kr-Eliza/tkey-open-hardware-reproduction/docs/images/render-3d-top.png

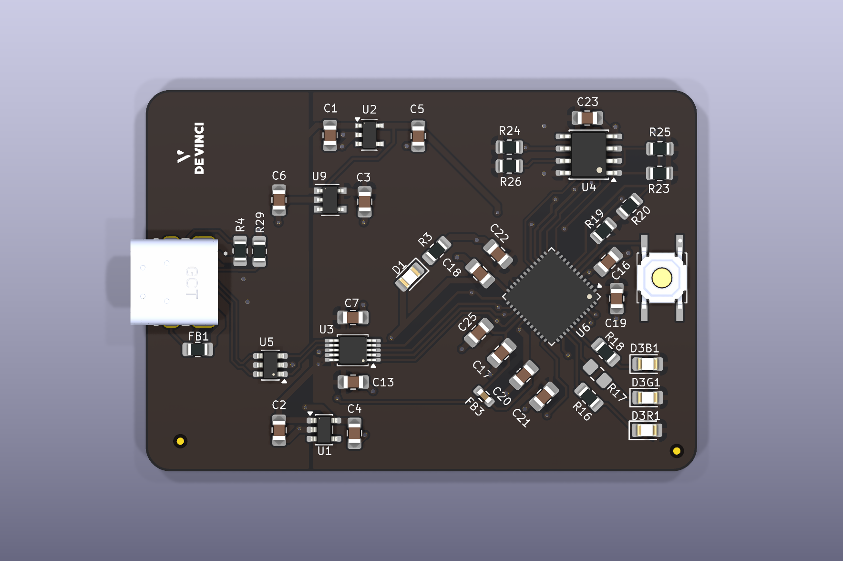
docs/images/render-3d-top.png
