kr-Eliza/tkey-open-hardware-reproduction/hardware/tk1-2layer/bom.csv

Reference | Value | Footprint | QUANTITY
C1-C6,C25 | 10uF | Capacitor_SMD:C_0805_2012Metric_Pad1.18x1.45mm_HandSolder | 7
C7,C13,C16-C23 | 0.10uF | Capacitor_SMD:C_0805_2012Metric_Pad1.18x1.45mm_HandSolder | 10
D1 | 0805 indicator LED, blue | LED_SMD:LED_0805_2012Metric_Pad1.15x1.40mm_HandSolder | 1
D3B1,D3G1,D3R1 | LED | LED_SMD:LED_0805_2012Metric_Pad1.15x1.40mm_HandSolder | 3
FB1 | FerriteBead | Resistor_SMD:R_0805_2012Metric_Pad1.20x1.40mm_HandSolder | 1
J3 | USB4085-GF-A_REVB | mta1:GCT_USB4085-GF-A_REVB | 1
R3,R16-R18 | 1k | Resistor_SMD:R_0805_2012Metric_Pad1.20x1.40mm_HandSolder | 4
R4,R29 | 5.1k | Resistor_SMD:R_0805_2012Metric_Pad1.20x1.40mm_HandSolder | 2
R19,R20,R23-R26 | 10k | Resistor_SMD:R_0805_2012Metric | 6
SW2 | PTS526_SK15_SMTR2_LFS | footprints:PTS526SK15SMTR2LFS | 1
U1 | MCP1824T-2502EOT | Package_TO_SOT_SMD:SOT-23-5 | 1
U2 | NCV8164ASN120T1G | Package_SO:TSOP-5_1.65x3.05mm_P0.95mm | 1
U3 | CH552E | Package_SO:MSOP-10_3x3mm_P0.5mm | 1
U4 | SST25VF080B-50-4x-S2Ax | Package_SO:SOIC-8_3.9x4.9mm_P1.27mm | 1
U5 | USBLC6-2SC6 | Package_TO_SOT_SMD:SOT-23-6 | 1
U6 | ICE40UP5K-SG48ITR | Package_DFN_QFN:QFN-48-1EP_7x7mm_P0.5mm_EP5.3x5.3mm | 1
U9 | NCP752BSN33T1G | mta1:NCP752BSN33T1G | 1
