kr-Eliza/tkey-open-hardware-reproduction/docs/schematic-2layer.pdf

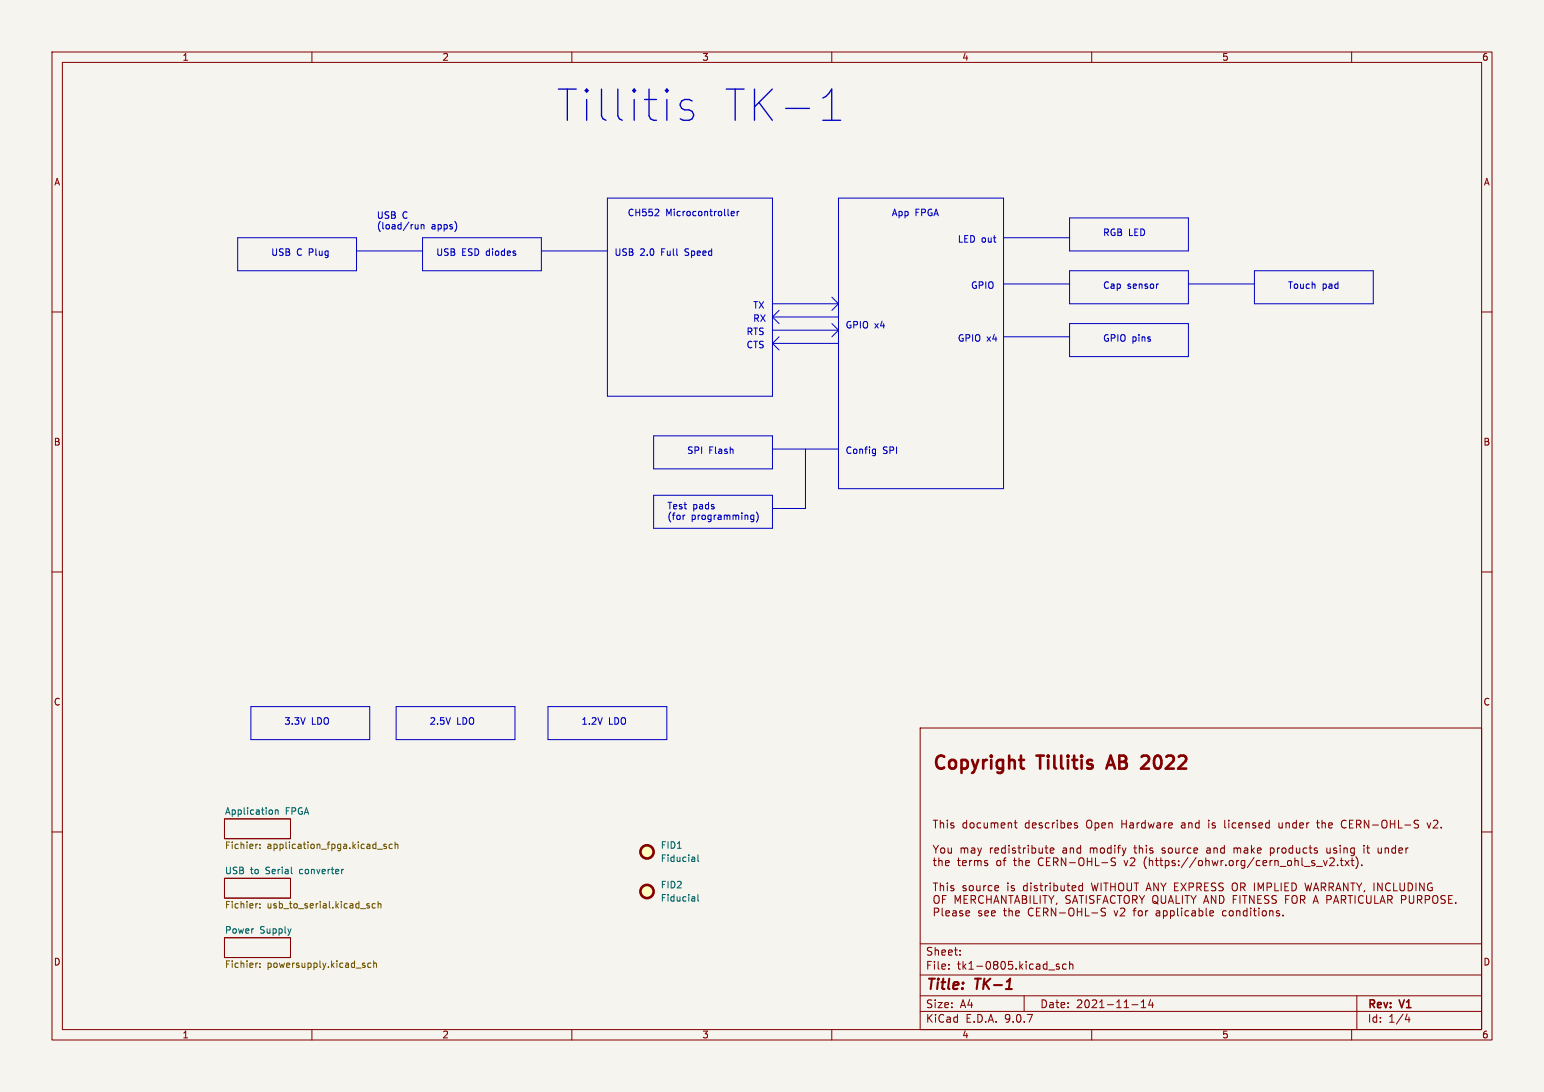
[picture p14: page 1]

(for programming) TX RTSRX CTS USB C

Touch pad Test pads

Power Supply Fichier: powersupply.kicad_sch

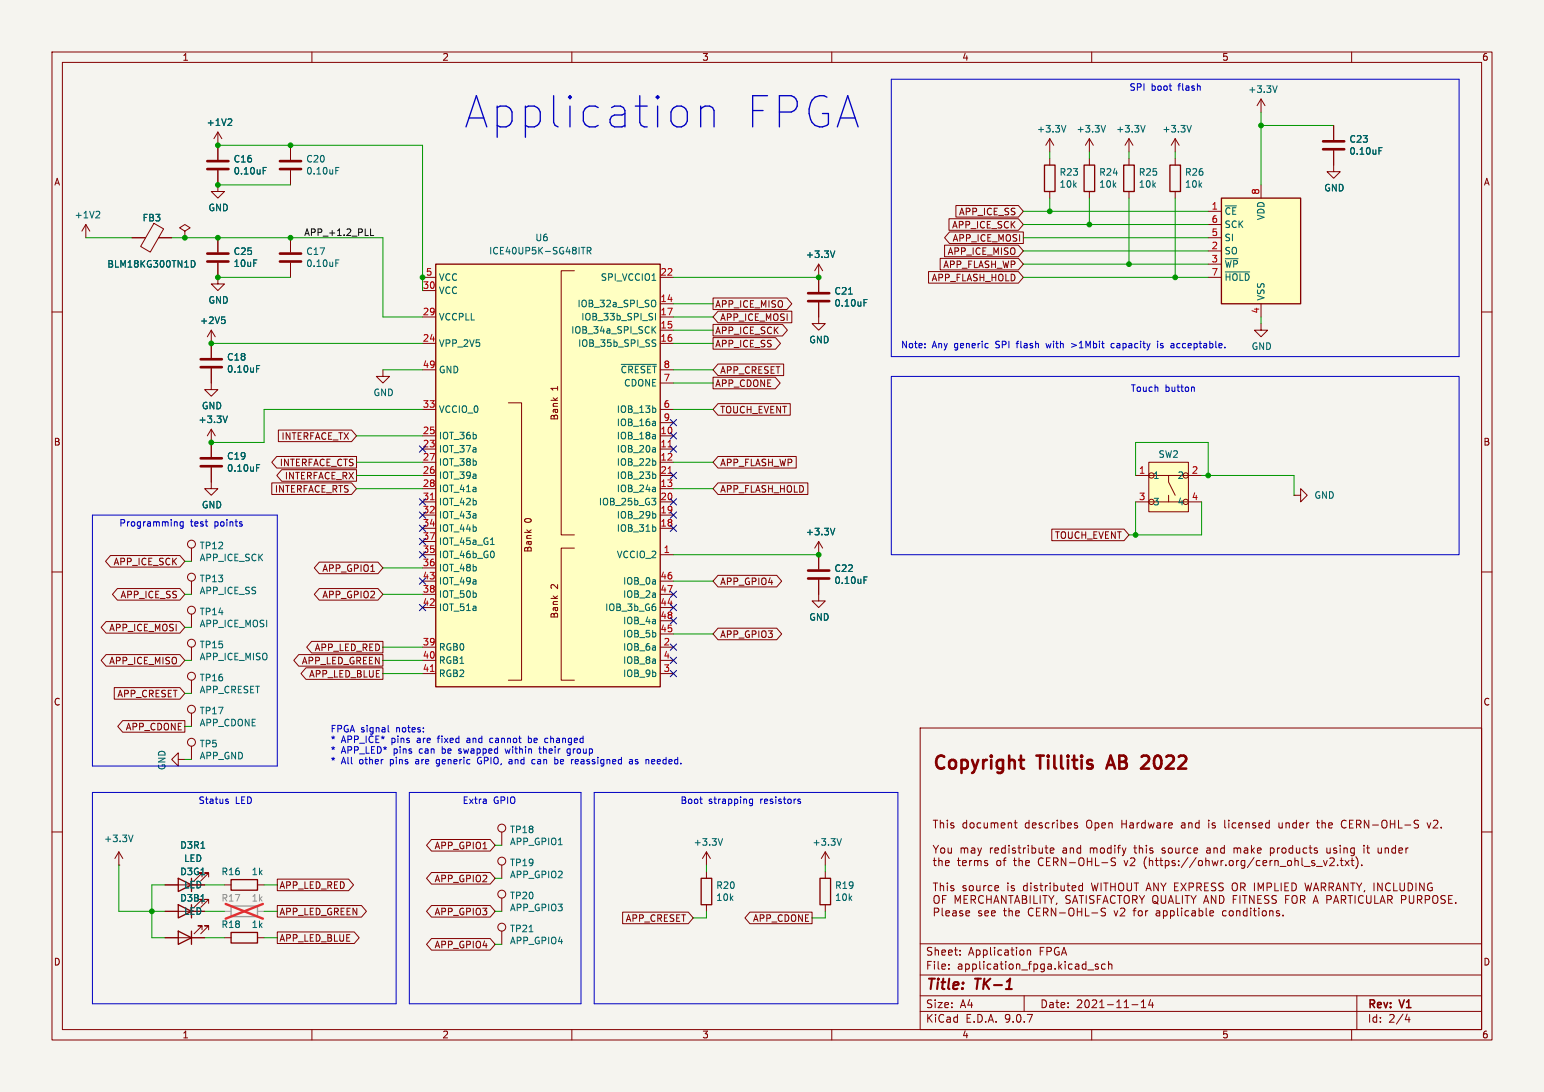
[picture p15: page 2]

FPGA signal notes: * APP_ICE* pins are fixed and cannot be changed

* APP_LED* pins can be swapped within their group

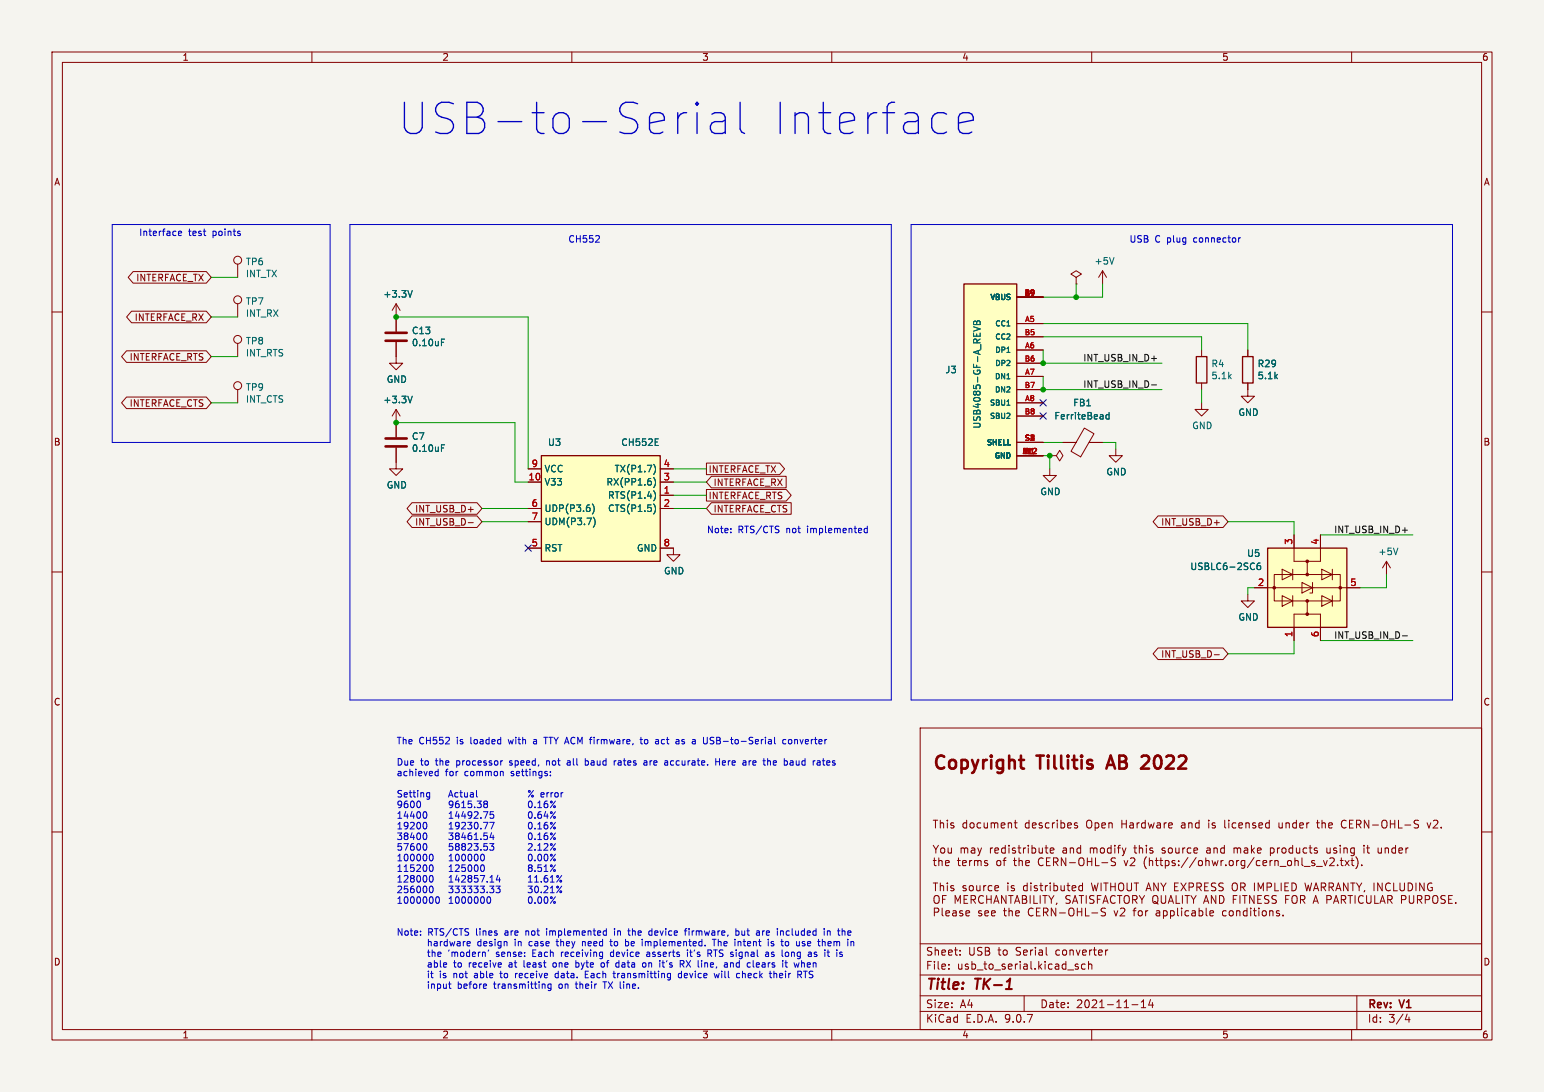
[picture p16: page 3]

4 U5 USBLC6-2SC6 GND GND GND GND

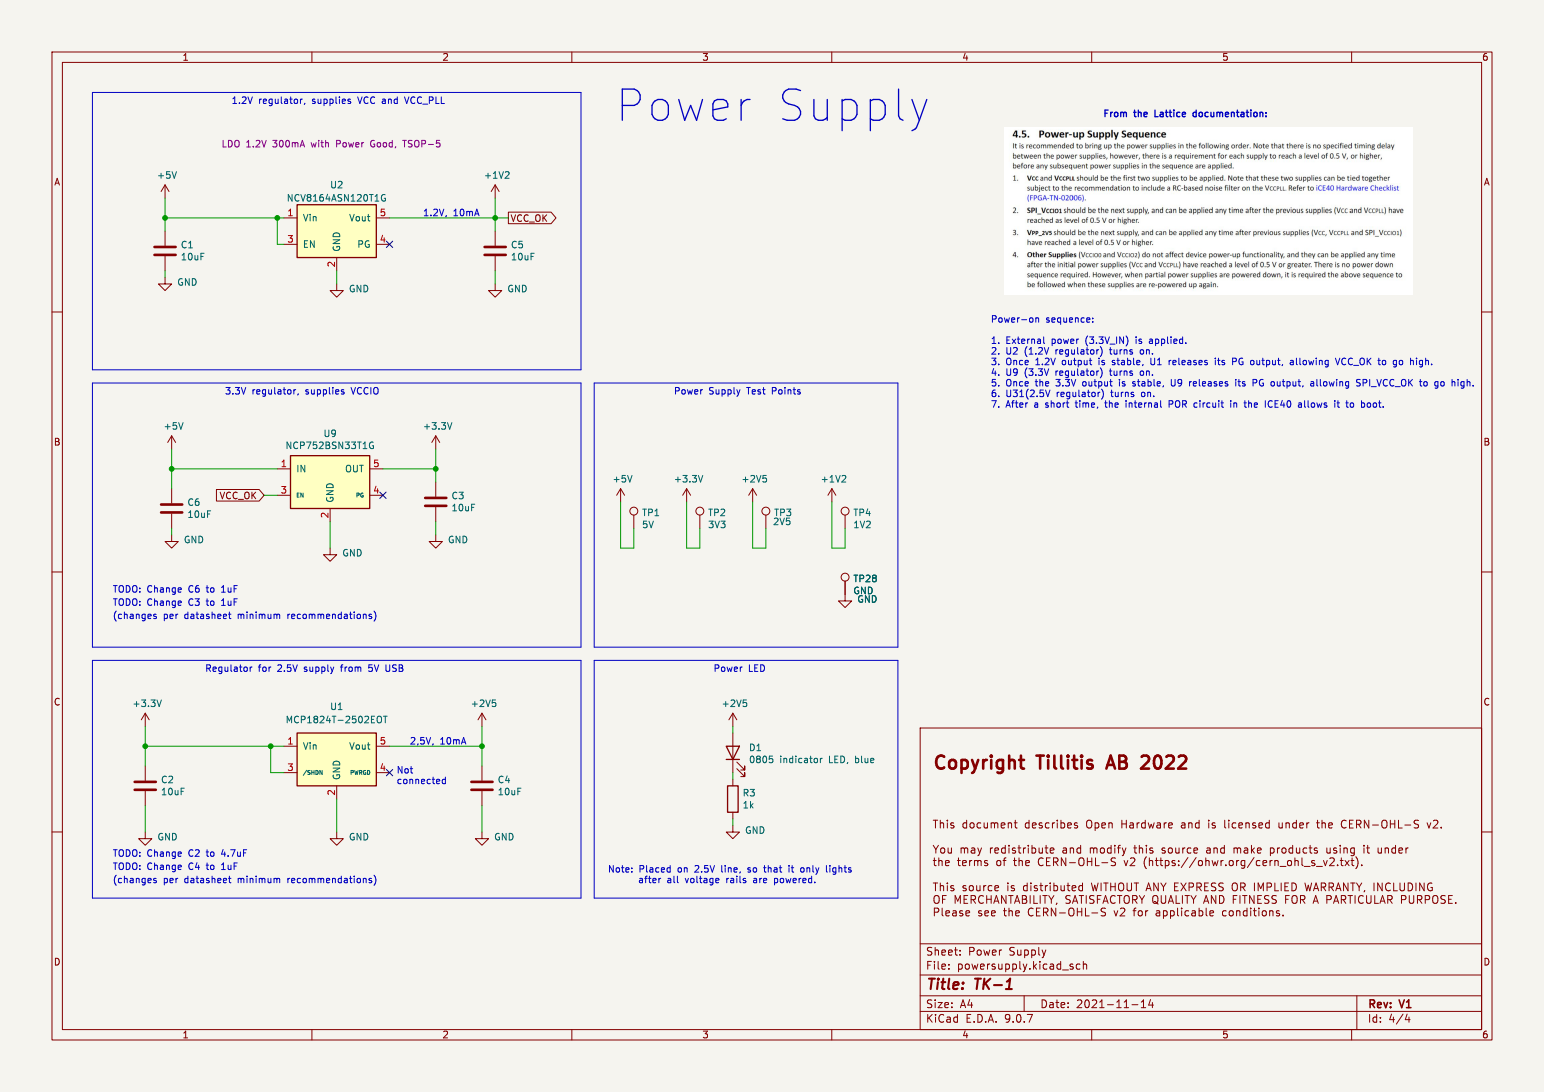
[picture p17: page 4]

LDO 1.2V 300mA with Power Good, TSOP-5 +5V C1
