kr-Eliza/tkey-open-hardware-reproduction/hardware/voltera-prototype/tk1.kicad_pcb

## KiCad design hardware/voltera-prototype/tk1.kicad_pcb (2026-04-01)

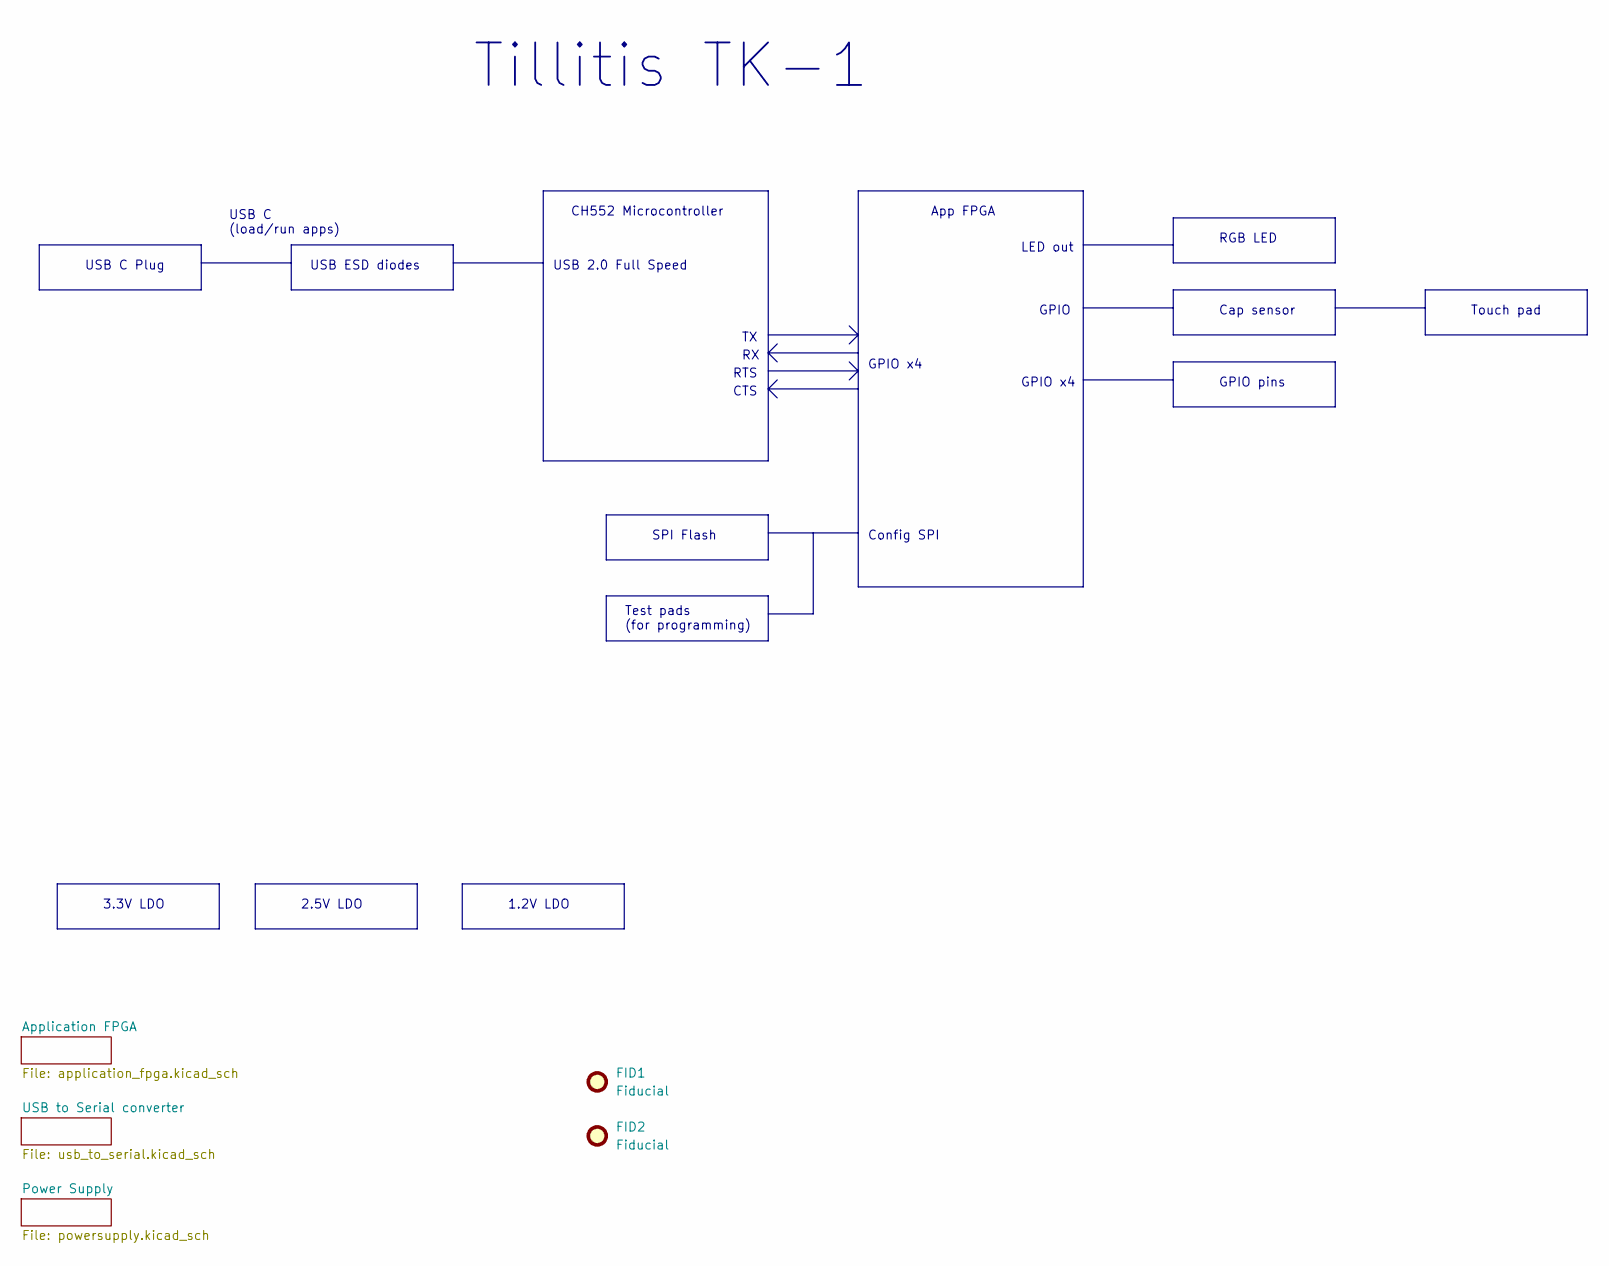
[picture p18: schematic tk1.kicad_sch, TK-1]

Parts:
FID1, FID2: Fiducial; Fiducial_0.75mm_Mask1.5mm

Notes on the sheet:
USB ESD diodes
Touch pad
GPIO x4
GPIO pins
Cap sensor
USB 2.0 Full Speed
RTS
USB C Plug
CH552 Microcontroller
RGB LED
USB C (load/run apps)
1.2V LDO
3.3V LDO
CTS
2.5V LDO
App FPGA
Config SPI
Tillitis TK-1
SPI Flash
GPIO
LED out
Test pads (for programming)

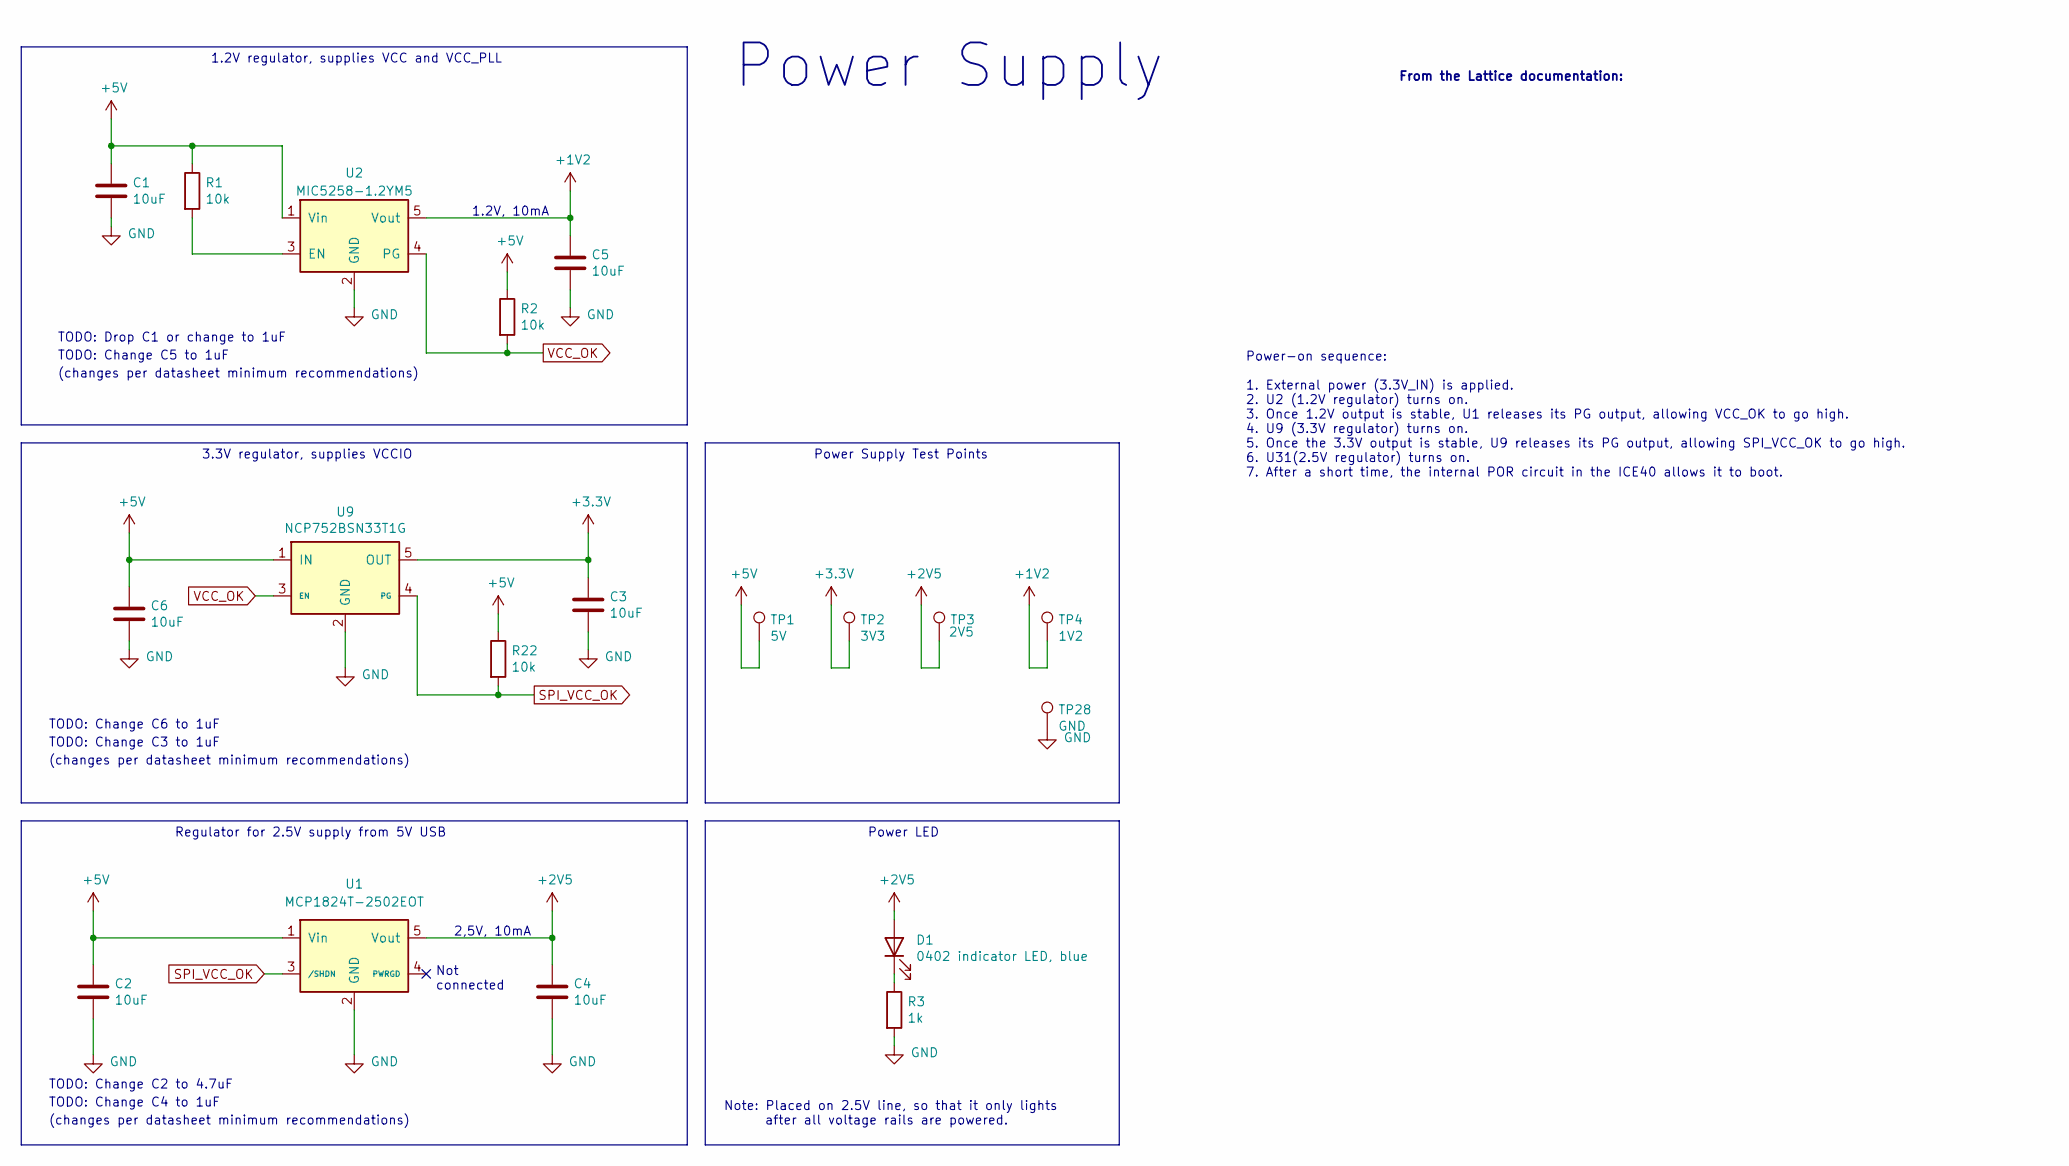
[picture p19: schematic powersupply.kicad_sch, TK-1]

Parts:
C1, C2, C3, C4, C5, C6: 10uF; C_0805_2012Metric
D1: 0402 indicator LED, blue; LED_0805_2012Metric; Manufacturer Part Number NCD0402B1
R1, R2, R22: 10k; R_0805_2012Metric
R3: 1k; R_0805_2012Metric
TP1: 5V; TestPoint_Pad_D1.0mm
TP2: 3V3; TestPoint_Pad_D1.0mm
TP3: 2V5; TestPoint_Pad_D1.0mm
TP4: 1V2; TestPoint_Pad_D1.0mm
TP28: GND; TestPoint_Pad_D1.0mm
U1: MCP1824T-2502EOT; SOT-23-5; Manufacturer Part Number MCP1824T-2502EOT
U2: MIC5258-1.2YM5; SOT-23-5; Manufacturer Part Number MIC5258-1.2YM5
U9: NCP752BSN33T1G; Manufacturer Part Number NCP752BSN33T1G

Connections:
+1V2: C5.1, TP4.1, U2.5 (Vout); also elsewhere on the board
+2V5: C4.1, D1.2 (A), TP3.1, U1.5 (Vout); also elsewhere on the board
+3.3V: C3.1, TP2.1, U9.5 (OUT); also elsewhere on the board
+5V: C1.1, C2.1, C6.1, R1.1, R2.1, R22.1, TP1.1, U1.1 (Vin), U2.1 (Vin), U9.1 (IN); also elsewhere on the board
GND: C1.2, C2.2, C3.2, C4.2, C5.2, C6.2, R3.2, TP28.1, U1.2 (GND), U2.2 (GND), U9.2 (GND); also elsewhere on the board
unnamed: D1.1 (K), R3.1
unnamed: R1.2, U2.3 (EN)
SPI_VCC_OK: R22.2, U1.3 (/SHDN), U9.4 (PG)
VCC_OK: R2.2, U2.4 (PG), U9.3 (EN)

Notes on the sheet:
Power-on sequence: 1. External power (3.3V_IN) is applied. 2. U2 (1.2V regulator) turns on. 3. Once 1.2V output is stable, U1 releases its PG output, allowing VCC_OK to go high. 4. U9 (3.3V regulator) turns on. 5. Once the 3.3V output is stable, U9 releases its PG output, allowing SPI_VCC_OK to go 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
TODO: Change C2 to 4.7uF
(changes per datasheet minimum recommendations)
TODO: Change C6 to 1uF
2,5V, 10mA
Note: Placed on 2.5V line, so that it only lights after all voltage rails are powered.
TODO: Change C3 to 1uF
1.2V, 10mA
Power Supply
TODO: Drop C1 or change to 1uF
TODO: Change C5 to 1uF
From the Lattice documentation:
1.2V regulator, supplies VCC and VCC_PLL
3.3V regulator, supplies VCCIO
TODO: Change C4 to 1uF
Not connected
Power Supply Test Points
Power LED
Regulator for 2.5V supply from 5V USB

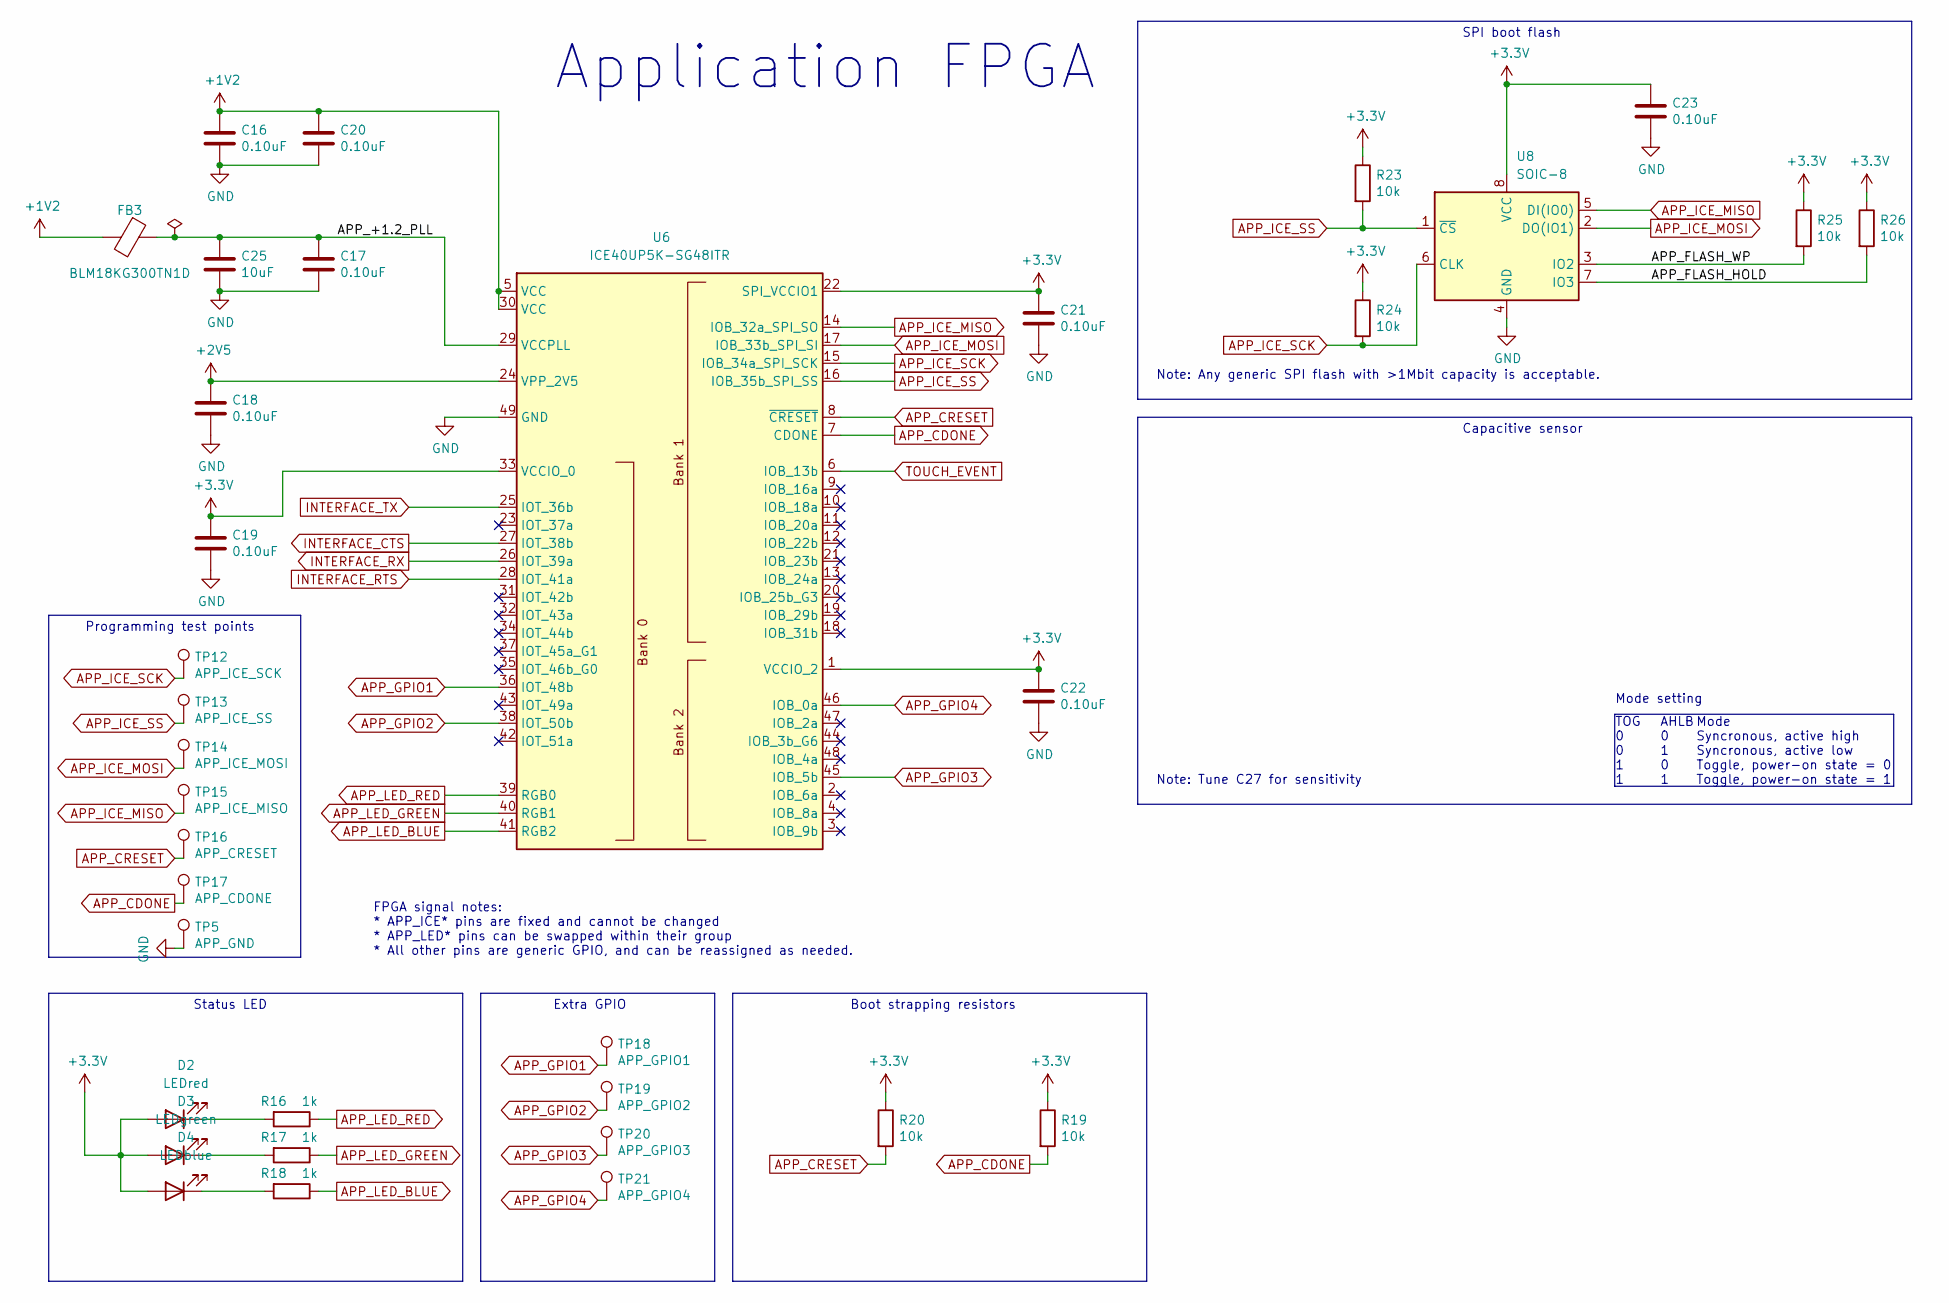
[picture p20: schematic application_fpga.kicad_sch, TK-1]

Parts:
C16, C17, C18, C19, C20, C21, C22, C23: 0.10uF; C_0805_2012Metric
C25: 10uF; C_0805_2012Metric
D2: LEDred; LED_0805_2012Metric_Pad1.15x1.40mm_HandSolder
D3: LEDgreen; LED_0805_2012Metric_Pad1.15x1.40mm_HandSolder
D4: LEDblue; LED_0805_2012Metric_Pad1.15x1.40mm_HandSolder
FB3: BLM18KG300TN1D; Ferritbead_0603_1608Metric; Manufacturer Part Number BLM18KG300TN1D
R16, R17, R18: 1k; R_0805_2012Metric
R19, R20, R23, R24, R25, R26: 10k; R_0805_2012Metric
TP5: APP_GND; TestPoint_Pad_D1.0mm
TP12: APP_ICE_SCK; TestPoint_Pad_D1.0mm
TP13: APP_ICE_SS; TestPoint_Pad_D1.0mm
TP14: APP_ICE_MOSI; TestPoint_Pad_D1.0mm
TP15: APP_ICE_MISO; TestPoint_Pad_D1.0mm
TP16: APP_CRESET; TestPoint_Pad_D1.0mm
TP17: APP_CDONE; TestPoint_Pad_D1.0mm
TP18: APP_GPIO1; TestPoint_Pad_D1.0mm
TP19: APP_GPIO2; TestPoint_Pad_D1.0mm
TP20: APP_GPIO3; TestPoint_Pad_D1.0mm
TP21: APP_GPIO4; TestPoint_Pad_D1.0mm
U6: ICE40UP5K-SG48ITR; QFN-48-1EP_7x7mm_P0.5mm_EP5.6x5.6mm; Manufacturer Part Number ICE40UP5K-SG48ITR
U8: SOIC-8; SOIC-8_3.9x4.9mm_P1.27mm; Manufacturer Part Number W25Q80DVUXIE

Connections:
+1V2: C16.1, C20.1, FB3.2, U6.5 (VCC), U6.30 (VCC); also elsewhere on the board
+2V5: C18.1, U6.24 (VPP_2V5); also elsewhere on the board
+3.3V: C19.1, C21.1, C22.1, C23.1, D2.2 (A), D3.2 (A), D4.2 (A), R19.1, R20.1, R23.1, R24.1, R25.1, R26.1, U6.1 (VCCIO_2), U6.22 (SPI_VCCIO1), U6.33 (VCCIO_0), U8.8 (VCC); also elsewhere on the board
/Application FPGA/APP_+1.2_PLL: C17.1, C25.1, FB3.1, U6.29 (VCCPLL)
/Application FPGA/APP_FLASH_HOLD: R26.2, U8.7 (IO3)
/Application FPGA/APP_FLASH_WP: R25.2, U8.3 (IO2)
APP_CDONE: R19.2, TP17.1, U6.7 (CDONE)
APP_CRESET: R20.2, TP16.1, U6.8 (~CRESET)
APP_GPIO1: TP18.1, U6.36 (IOT_48b)
APP_GPIO2: TP19.1, U6.38 (IOT_50b)
APP_GPIO3: TP20.1, U6.45 (IOB_5b)
APP_GPIO4: TP21.1, U6.46 (IOB_0a)
APP_ICE_MISO: TP15.1, U6.14 (IOB_32a_SPI_SO), U8.5 (DI(IO0))
APP_ICE_MOSI: TP14.1, U6.17 (IOB_33b_SPI_SI), U8.2 (DO(IO1))
APP_ICE_SCK: R24.2, TP12.1, U6.15 (IOB_34a_SPI_SCK), U8.6 (CLK)
APP_ICE_SS: R23.2, TP13.1, U6.16 (IOB_35b_SPI_SS), U8.1 (~CS)
APP_LED_BLUE: R18.1, U6.41 (RGB2)
APP_LED_GREEN: R17.1, U6.40 (RGB1)
APP_LED_RED: R16.1, U6.39 (RGB0)
GND: C16.2, C17.2, C18.2, C19.2, C20.2, C21.2, C22.2, C23.2, C25.2, TP5.1, U6.49 (GND), U8.4 (GND); also elsewhere on the board
INTERFACE_CTS: U6.27 (IOT_38b); also elsewhere on the board
INTERFACE_RTS: U6.28 (IOT_41a); also elsewhere on the board
INTERFACE_RX: U6.26 (IOT_39a); also elsewhere on the board
INTERFACE_TX: U6.25 (IOT_36b); also elsewhere on the board
unnamed: D3.1 (K), R17.2
TOUCH_EVENT: U6.6 (IOB_13b)

Notes on the sheet:
Application FPGA
Mode Syncronous, active high Syncronous, active low Toggle, power-on state = 0 Toggle, power-on state = 1
Capacitive sensor
SPI boot flash
FPGA signal notes: * APP_ICE* pins are fixed and cannot be changed * APP_LED* pins can be swapped within their group * All other pins are generic GPIO, and can be reassigned as needed.
Boot strapping resistors
AHLB 0 1 0 1
Status LED
Note: Tune C27 for sensitivity
Programming test points
Mode setting
Note: Any generic SPI flash with >1Mbit capacity is acceptable.
Extra GPIO
TOG 0 0 1 1

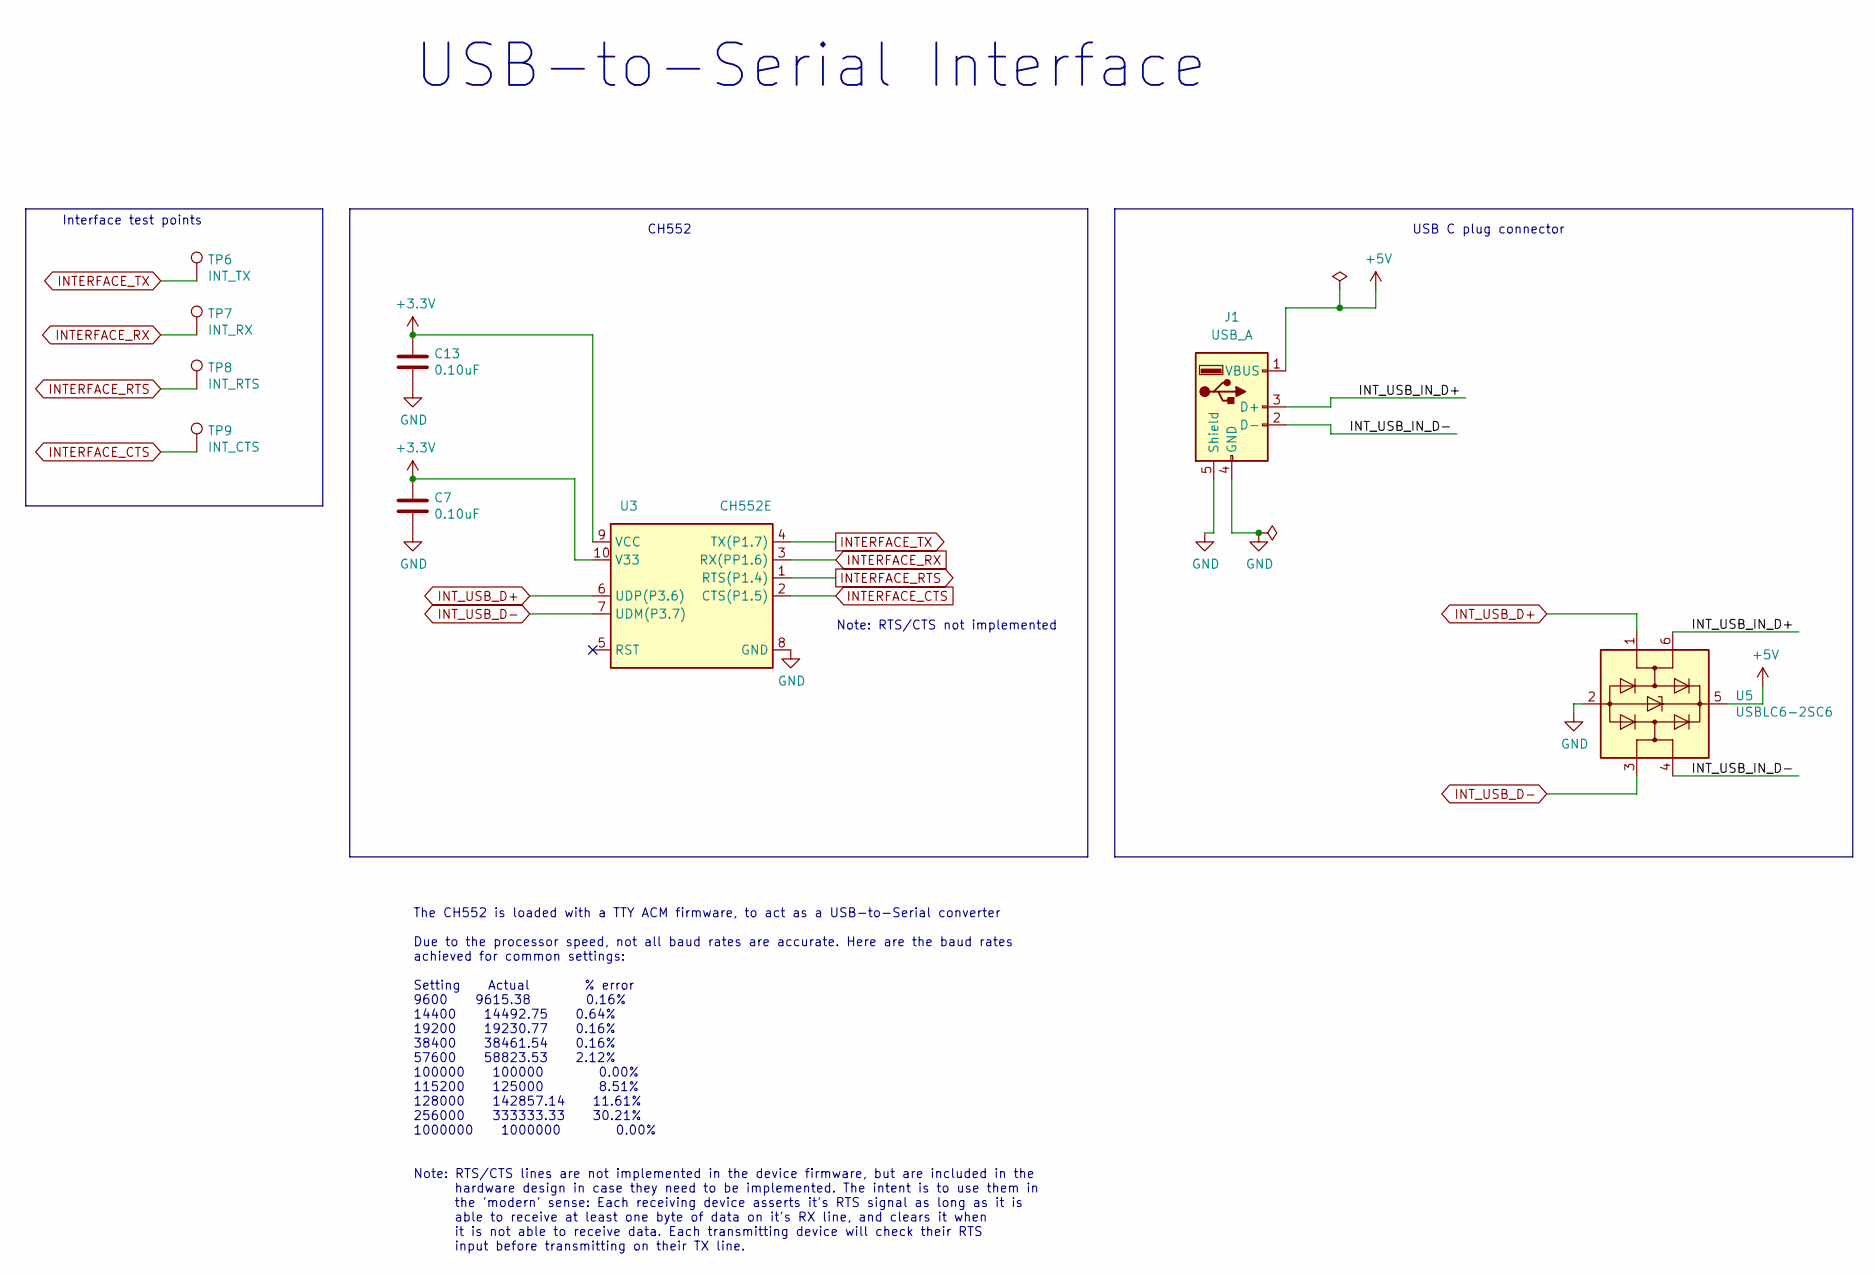
[picture p21: schematic usb_to_serial.kicad_sch, TK-1]

Parts:
C7, C13: 0.10uF; C_0805_2012Metric
J1: USB_A; USB_A_Kycon_KUSBX-AS1N-B_Horizontal
TP6: INT_TX; TestPoint_Pad_D1.0mm
TP7: INT_RX; TestPoint_Pad_D1.0mm
TP8: INT_RTS; TestPoint_Pad_D1.0mm
TP9: INT_CTS; TestPoint_Pad_D1.0mm
U3: CH552E; MSOP-10_3x3mm_P0.5mm; Manufacturer Part Number CH552E
U5: USBLC6-2SC6; SOT-23-6; Manufacturer Part Number USBLC6-2SC6

Connections:
+3.3V: C7.1, C13.1, U3.9 (VCC), U3.10 (V33); also elsewhere on the board
+5V: J1.1 (VBUS), U5.5 (VBUS); also elsewhere on the board
/USB to Serial converter/INT_USB_IN_D+: J1.3 (D+), U5.6 (I/O1)
/USB to Serial converter/INT_USB_IN_D-: J1.2 (D-), U5.4 (I/O2)
GND: C7.2, C13.2, J1.4 (GND), J1.5 (Shield), U3.8 (GND), U5.2 (GND); also elsewhere on the board
INTERFACE_CTS: TP9.1, U3.2 (CTS(P1.5)); also elsewhere on the board
INTERFACE_RTS: TP8.1, U3.1 (RTS(P1.4)); also elsewhere on the board
INTERFACE_RX: TP7.1, U3.3 (RX(PP1.6)); also elsewhere on the board
INTERFACE_TX: TP6.1, U3.4 (TX(P1.7)); also elsewhere on the board
INT_USB_D+: U3.6 (UDP(P3.6)), U5.1 (I/O1)
INT_USB_D-: U3.7 (UDM(P3.7)), U5.3 (I/O2)

Notes on the sheet:
USB C plug connector
CH552
USB-to-Serial Interface
The CH552 is loaded with a TTY ACM firmware, to act as a USB-to-Serial converter Due to the processor speed, not all baud rates are accurate. Here are the baud rates achieved for common settings: Setting Actual % error 9600 9615.38 0.16% 14400 14492.75 0.64% 19200 19230.77 0.16% 38400 38461.54 0.16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
Interface test points
Note: RTS/CTS not implemented

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
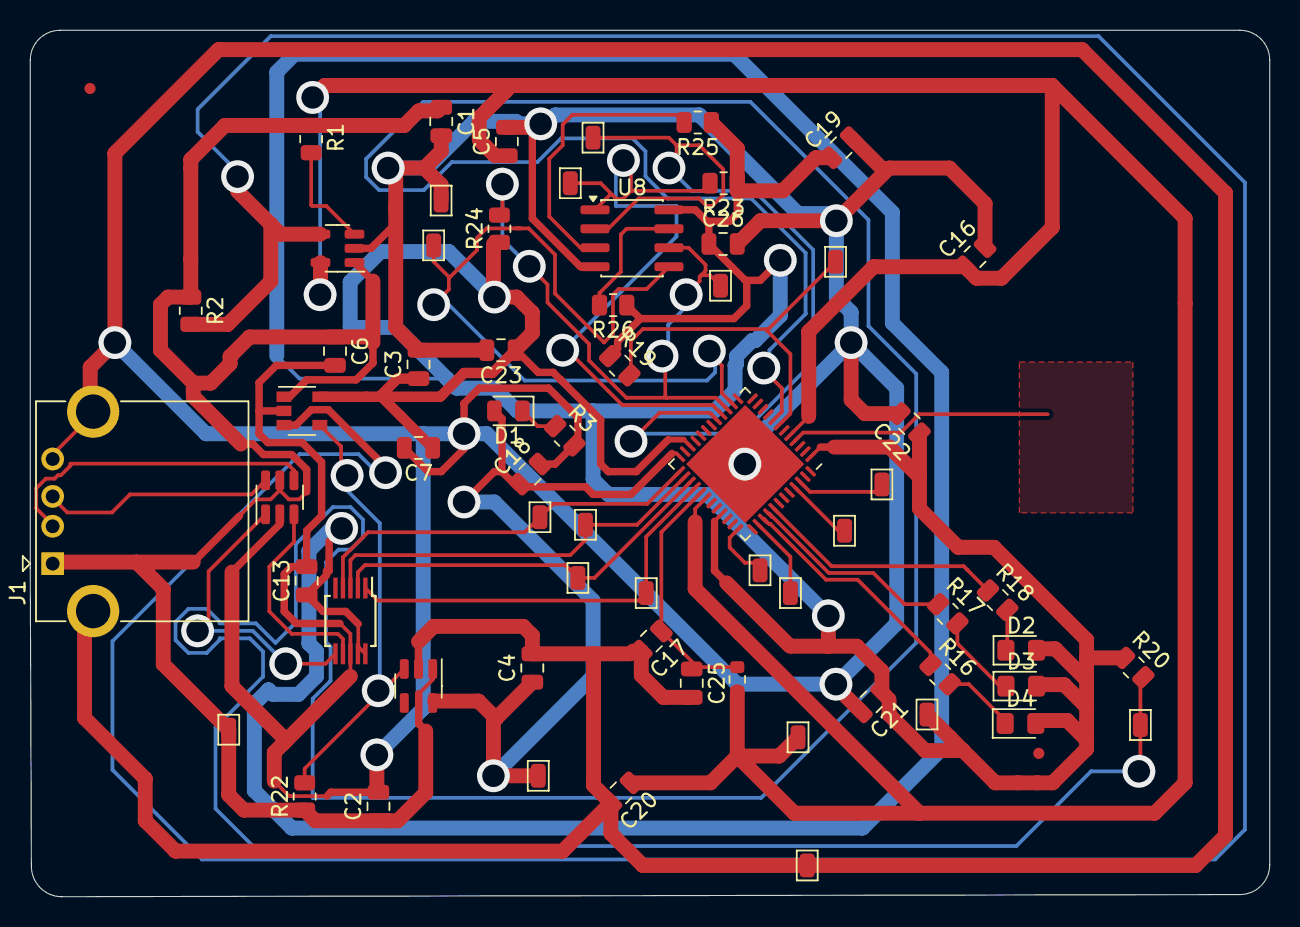
[picture p22: board tk1.kicad_pcb from above]

Board: 2 copper layers, 83.0 x 58.0 mm, 66 parts (0 on the bottom side), 36 nets.

Other parts of the board:
C26: 0.10uF; C_0805_2012Metric

Their connections:
+3.3V: C26.1; also elsewhere on the board
GND: C26.2; also elsewhere on the board
